Mama-72/bldc-hardware/(commit log)

2025-05-05 Premier commit après synchronisation du projet
    premier commit après avoir synchroniser le projet dans mon espace de travail. plusieurs composants sont inéxistant dans la librairie. il vas falloir les rajouter par la suite et commit le projet mis a jour
    [BLDC_4-2025-05-05-12-05-21.sch, BLDC_4.kicad_pcb, BLDC_4.kicad_sch, CAN-2025-05-05-12-05-21.sch, CAN.kicad_sch, Power-2025-05-05-12-05-21.sch, Power.kicad_sch, STM32F4 64LQFP-2025-05-05-12-05-21.sch]
2025-05-06 ajour des corps 3D des mos D2PARK7
    [BLDC_4.kicad_pcb]
